ungurasu/stabilizator_tensiune_ers/Documentatie.pdf

UNIVERSITATEA POLITEHNICA din BUCURESTI
Facultatea de Electronică, Telecomunicații și Tehnologia Informației Ungurașu Ioan-Andrei 435E

București 2020

# Referat Proiect 1 - Dispozitive și circuite electronice Stabilizator de tensiune cu element de reglaj serie

Ungurașu Ioan-Andrei
Grupa 435E

## Cuprins

## Tema proiectului și datele

### Date stabilizator:

- N = 21
- Tensiunea de ieșire reglabilă în intervalul 10.5 – 21 V.
- Sarcina la ieșire de 1.05 kOhm.
- Deriva termică 1.06 < 2 mV/oC.
- Protecție la suprasarcină la 100 oC și la curent maxim 0.4 A.
- Tensiunea de intrare în intervalul 37.8 – 42 V.
- Domeniul temperaturilor 0o – 70oC.
- Amplificarea în tensiune minimă (în buclă deschisă) a amplificatorului de eroare:
- minim 200.
- Semnalizarea prezenței tensiunilor de intrare/ieșire cu diodă de tip LED.

### Cerințe privind realizarea:

Circuitul va fi realizat sub forma unui modul electronic a carui structura de interconectare (PCB) va respecta urmatoarele cerinte de proiectare:
- Dimensiunile PCB: 40mm x 40mm;
- Material FR4, dublu strat/ grosimea foliei de cupru 18 μm, grosimea plăcii 1,5 mm;
- Originea (punctul de coordonate (0,0)) va fi plasat în colţul din stânga-jos al plăcii de cablaj imprimat, astfel toate elementele proiectului vor avea coordonate pozitive;
- Dimensiunea traseelor şi spaţierea lor în concordanţă cu specificaţiile menţionate.
- Toate componentele se vor plasa pe faţă superioară a plăcii, TOP;
- Componente pasive SMD chip 0805;
- Se pot folosi numai tranzistoare bipolare şi TEC-MOS în capsule SMD (SOT 23, DPAK). Tranzistoarele TEC-J pot fi utilizate numai dacă se justifică necesitatea
acestora.
- Puncte de test: pătrate, maxim 5 – justificate de planul de testare;
- Originea (punctul de coordonate (0,0)) va fi plasat în colţul din stânga-jos al plăcii de cablaj imprimat, astfel toate elementele proiectului vor avea coordonate pozitive;
- Faţă de marginea plăcii, se va păstra o gardare („clearance”) de 1,2 mm; aici nu vor fi plasate componente, trasee, texte, etc.;
- Placa va fi prevăzută cu 2 markeri fiduciali globali pe layerul TOP, la distanța de 200 mil față de marginea plăcii, plasați convenabil; acești markeri vor exista și pe layerul
- Solder Paste Top (suprapuși peste cei de pe TOP); vor fi utilizați în momentul alinierii sablonului cu placa. Marcajul fiducial va fi un cerc de diametru minim 1mm pe layerul respectiv, aflat într-un spațiu circular de diametru minim dublu față de cercul interior, în care nu se va afla nimic pe nici un layer;
- Se va acorda o atenţie sporită layer-ului Mască de inscripţionare (Silk Screen); acesta nu trebuie să se regăsească pe pad-urile componentelor;
- Se va genera un nou layer neelectric, MECANIC. Acesta va conţine: conturul plăcii, desenul de găurire („drill drawing”) şi tabelul de găurire („drill chart/table”, „drill legend”), o secţiune transversală prin circuitul imprimat proiectat („layer stack-up”) şi informaţiile mecanice necesare pentru fabricaţia PCB;
- Cotele de gabarit/dimensiunile plăcii nu trebuie să se regăsească pe layer-ul electric TOP; acestea, dacă există, se vor plasa pe un layer neelectric mecanic;
- Placa va fi prevăzută cu elementele de identificare ale proiectantului (nume, prenume, grupă, PDCE I 2020-2021).

### Cerințe privind traseele de interconectare

- Curent de sute de 1A – 30 mil ;
- Curent de sute de mA - 22 mil;
- Semnal – 16 mil ;
- Spaţierea, în toate cazurile, va fi de 12 mil.
- Găurile de trecere pentru semnale (vias-uri) vor avea diametrul de 0,4 mm.

### Cerințe privind fisierele Gerber standard 274X

- Conturul plăcii (board outline);
- Layer electric TOP;
- Layer electric BOTTOM;
- Layer neelectric Mască de inscripţionare (Silk Screen Top);
- Layer neelectric Mască de protecţie (Solder Mask Top);
- Layer neelectric Şablon (Solder Paste Top);
- Lista de aperturi şi fişierul de găurire.

## Schema bloc

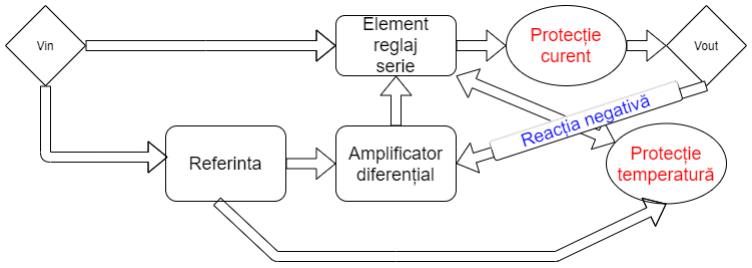
[picture p1: figure]

## Schema electrică

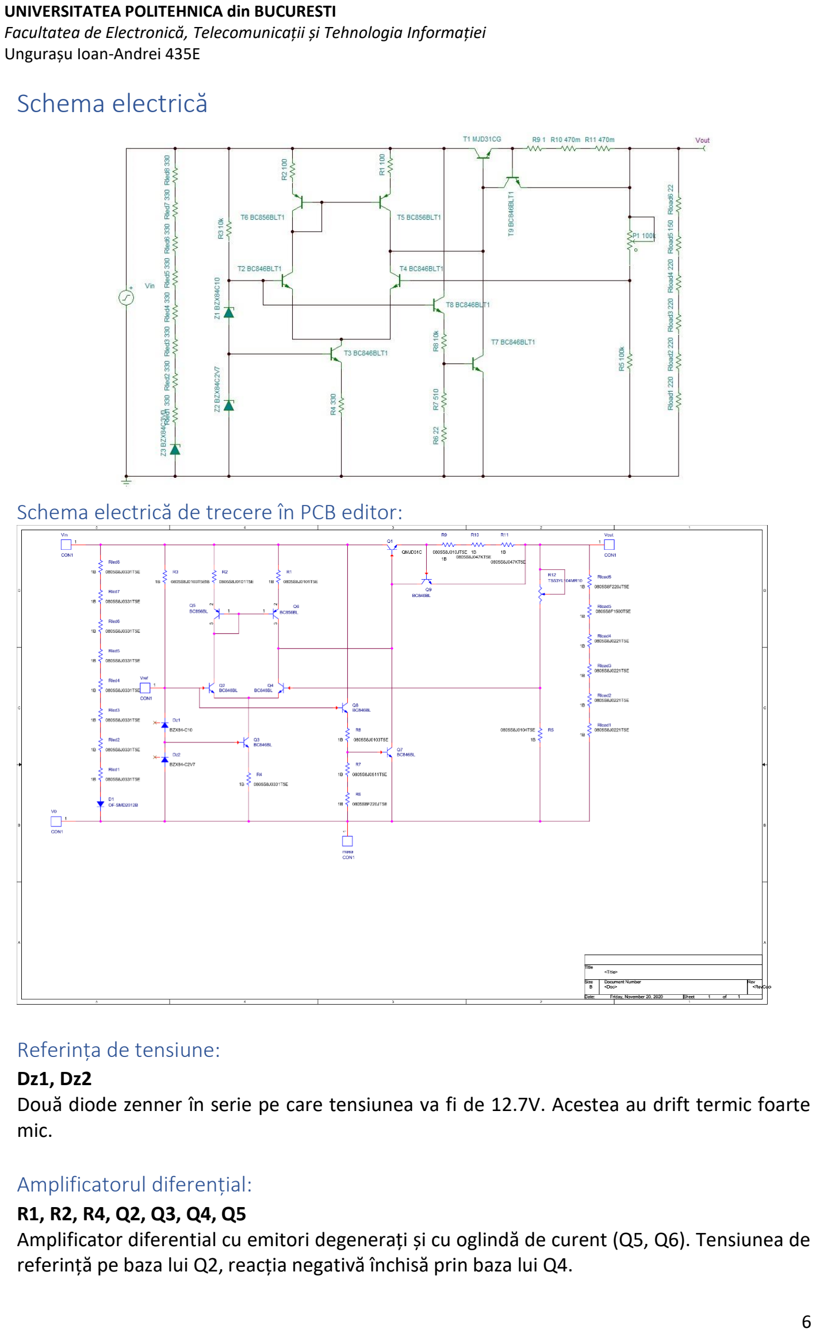
[picture p2: page 6]

### Schema electrică de trecere în PCB editor:

### Referința de tensiune:

Dz1, Dz2
Două diode zenner în serie pe care tensiunea va fi de 12.7V. Acestea au drift termic foarte mic.

### Amplificatorul diferențial:

R1, R2, R4, Q2, Q3, Q4, Q5
Amplificator diferential cu emitori degenerați și cu oglindă de curent (Q5, Q6). Tensiunea de referință pe baza lui Q2, reacția negativă închisă prin baza lui Q4.

Amplificarea în buclă deschisă:
av = gm4 × Ro = gm4 × (Rπ1 + (1 + β) × [(R5 + RP1

)||RLOAD]).

### Element de reglaj serie:

Q1
De tip MJD31C pentru a face față curentuluide ordinul sutelor de miliamperi care poate apărea înainte de activarea protecției în curent.

### Rețeaua de reacție:

P1(R12),R5
Tensiunea eșantionată Veș | = VOUT | ×

R5
R5+R12

### Circuitul de protecție în temperatură:

Q8, Q7, R6, R7, R8
Deriva termică fiind de 2mV/degC, și observând că tranzistorul are nevoie de Vbe aproximativ 800mV în viața reală pentru a se deschide complet, am pus la baza lui un divizor de tensiune care să îl țină la 600mV.

### Circuitul de protecție în curent:

Q9, R9, R10, R11
Am ales rezistențele în așa fel încât atunci când pe la colectorul lui Q1 avem un curent de 400mA, să avem Vbe9= 800mV, ca să se deschide Q9, protecția.

### Calcule

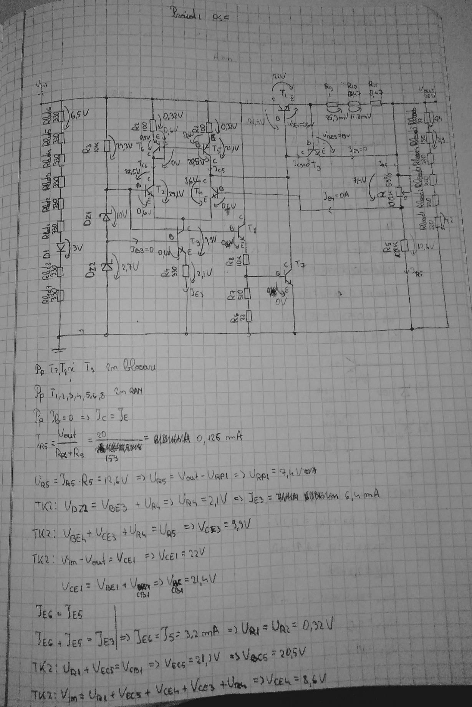
[picture p3: figure]

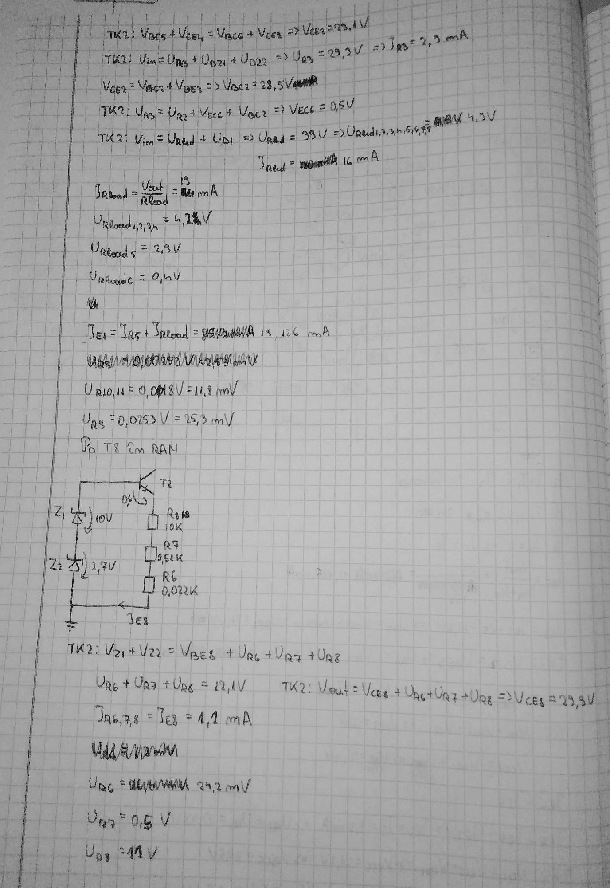
[picture p4: figure]

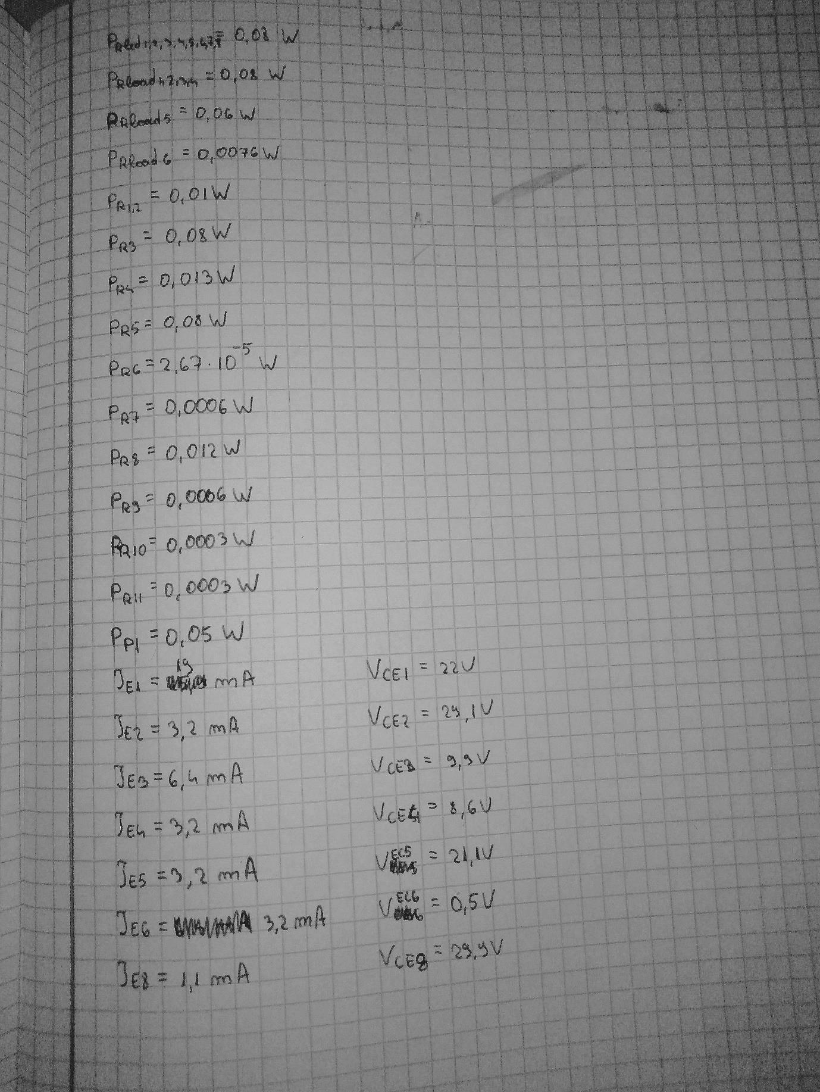
[picture p5: figure]

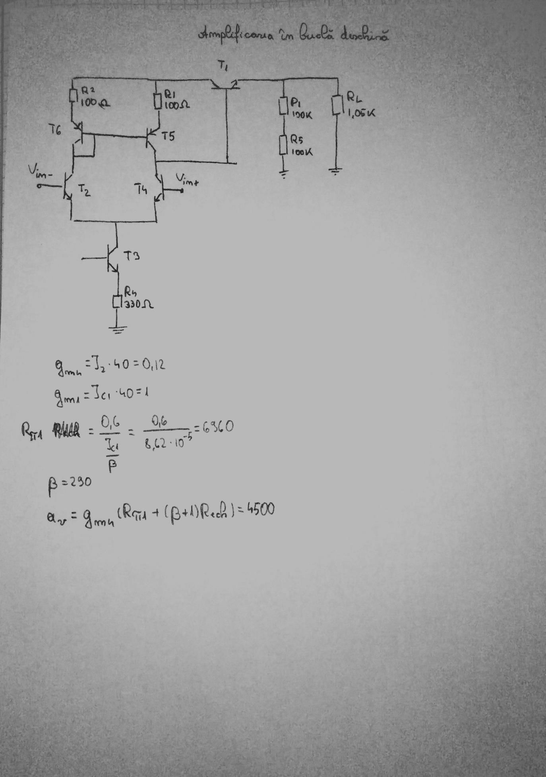
[picture p6: figure]

### Componente

Item | Quantity | Reference | Part | Valori standard | Tip constructiv
1 | 1 | Dz1 | BZX84-C10
2 | 1 | Dz2 | BZX84-C2V7
3 | 1 | D1 | OF-SMD2012B
4 | 1 | Q1 | QMJD31C
5 | 6 | Q2, Q3, Q4, Q7, Q8, Q9 | BC846BL
6 | 2 | Q5, Q6 | BC856BL
7 | 9 | Rled1, Rled2, Rled3, Rled4, R4, Rled5, Rled6, Rled7, Rled8 | 0805S8J0331T5E | 330 [Ohm] | Thick Film
8 | 4 | Rload1, Rload2, Rload3, Rload4 | 0805S8J0221T5E | 220 [Ohm] | Thick Film
9 | 1 | Rload5 | 0805S8F1500T5E | 150 [Ohm] | Thick Film
10 | 2 | Rload6, R6 | 0805S8F220JT5E | 22 [Ohm] | Thick Film
11 | 2 | R1, R2 | 0805S8J0101T5E | 100 [Ohm] | Thick Film
12 | 2 | R3, R8 | 0805S8J0103T5E | 10 [kOhm] | Thick Film
13 | 1 | R5 | 0805S8J0104T5E | 100 [kOhm] | Thick Film
14 | 1 | R7 | 0805S8J0511T5E | 510 [Ohm] | Thick Film
15 | 1 | R9 | 0805S8J010JT5E | 1 [Ohm] | Thick Film
16 | 2 | R10, R11 | 0805S8J047KT5E | 0.47 [Ohm] | Thick Film
17 | 1 | R12 | TS53YL104MR10 | 100 [kOhm] | Single Turn Cermet Sealed
18 | 5 | masa, Vref, Vout, Vin, V0 | CON1

## Simulări

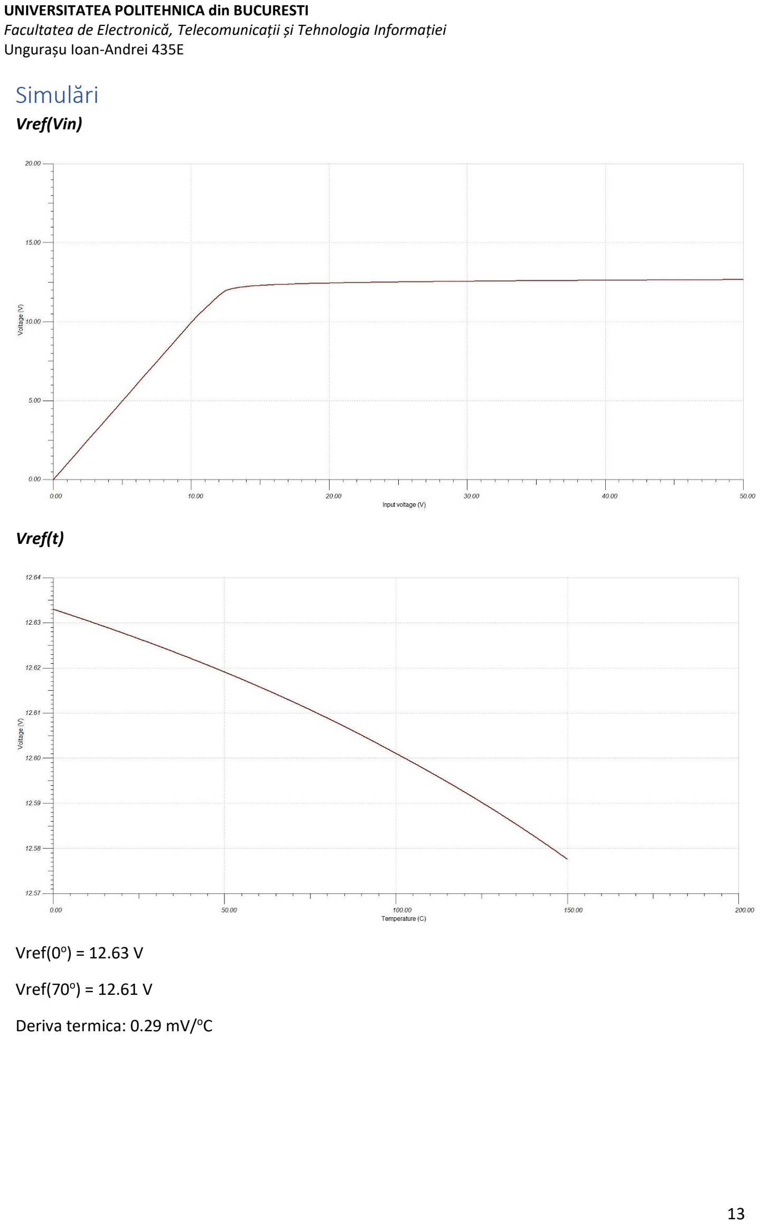
[picture p7: page 13]

Vref(Vin)

Vref(t)

Vref(0o
) = 12.63 V

Vref(70o
) = 12.61 V

Deriva termica: 0.29 mV/oC

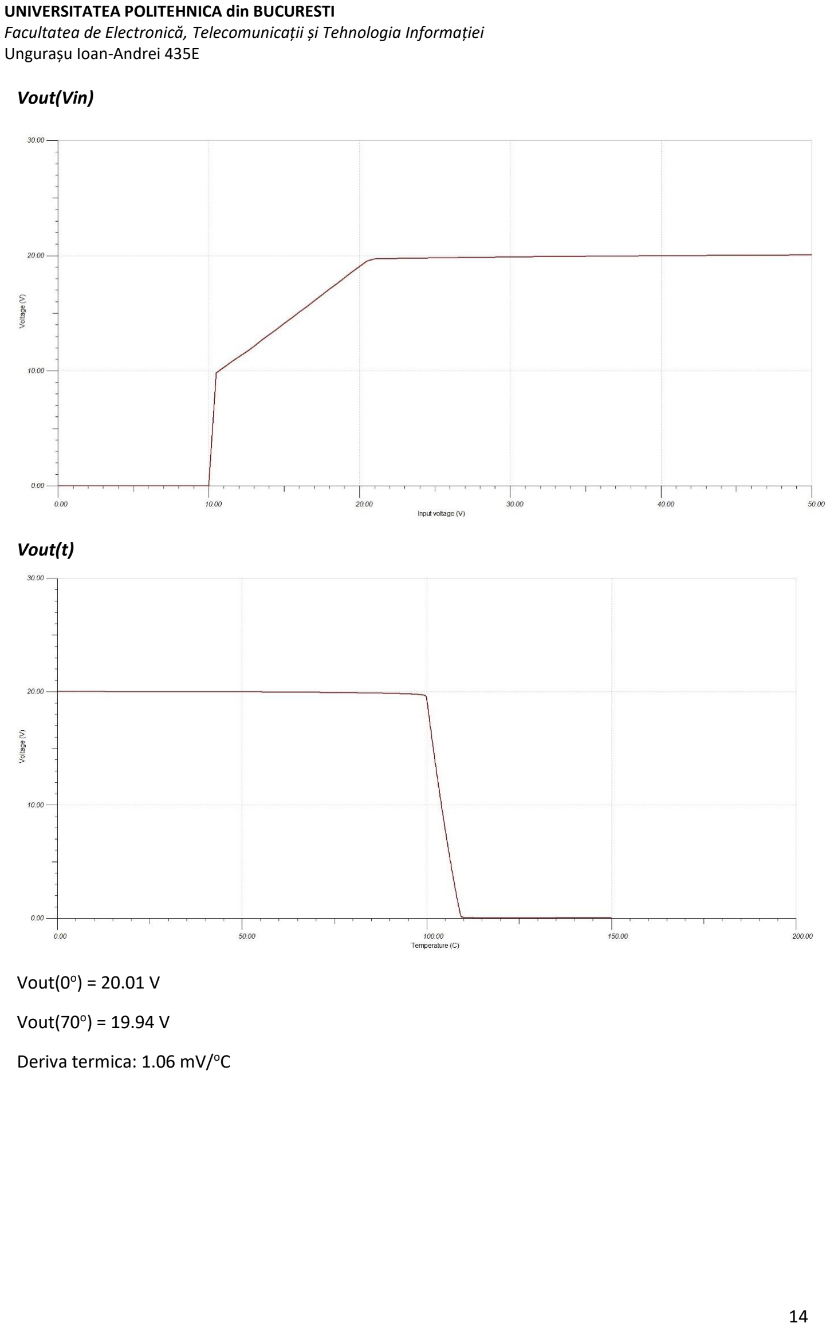
[picture p8: page 14]

Vout(Vin)

Vout(t)

Vout(0o
) = 20.01 V

Vout(70o
) = 19.94 V

Deriva termica: 1.06 mV/oC

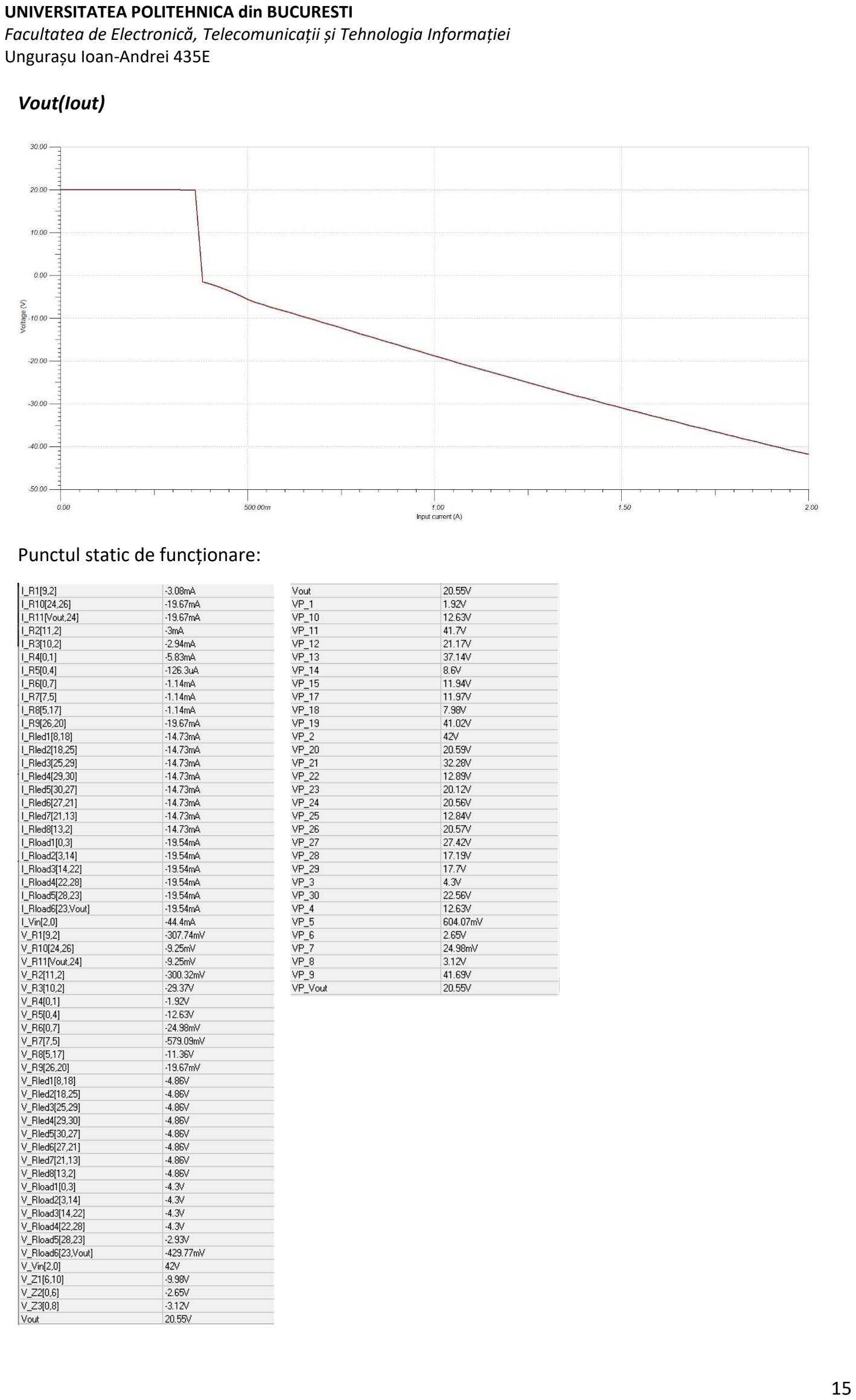
[picture p9: page 15]

Vout(Iout)

Punctul static de funcționare:

## Layout

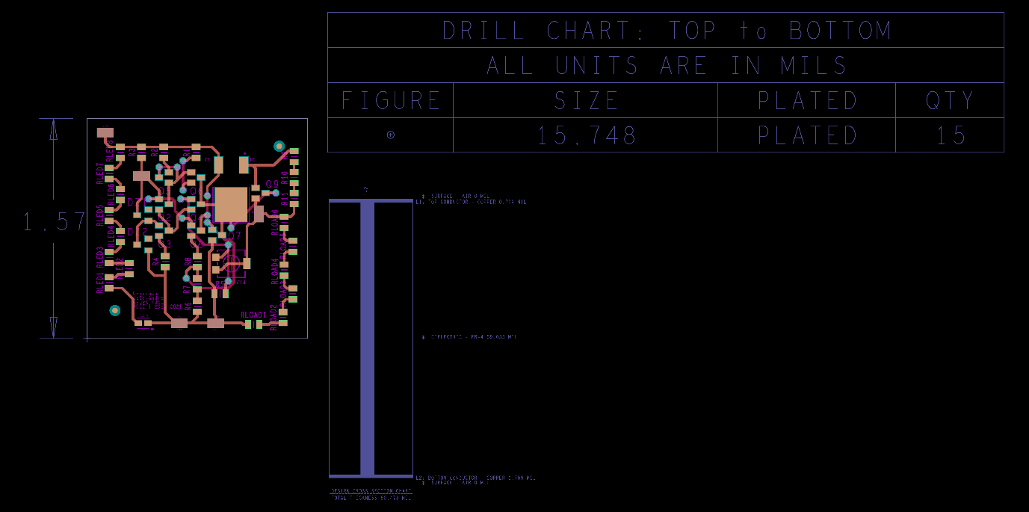
[picture p10: figure]

## TOP

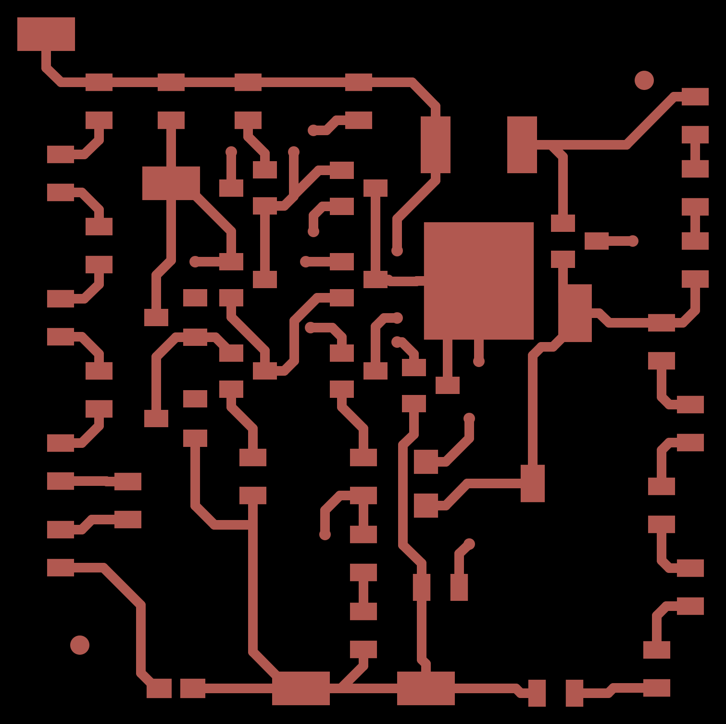
[picture p11: figure]

## BOT

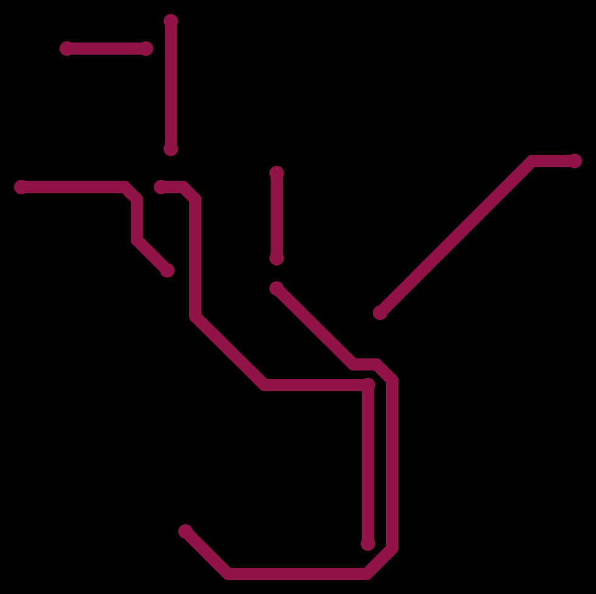
[picture p12: figure]

## Silk Screen Top

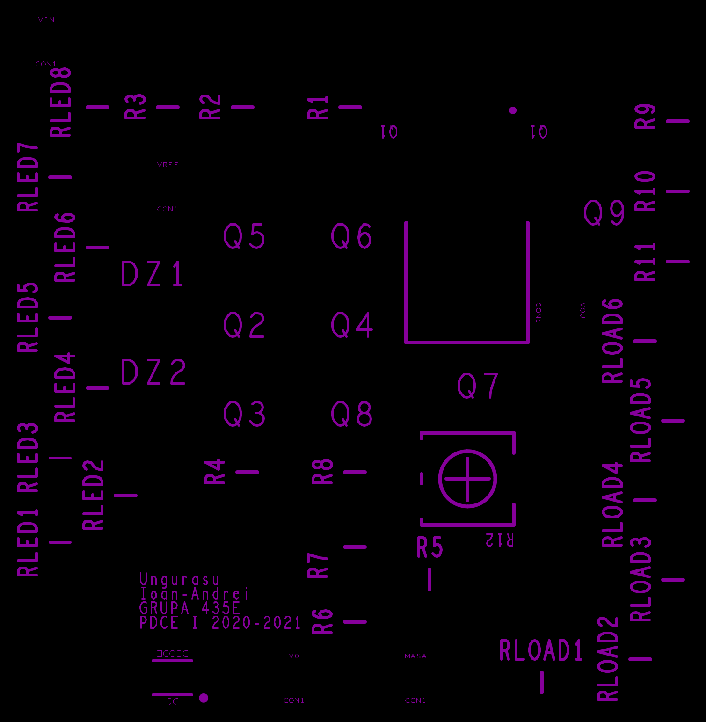
[picture p13: figure]

## Solder Mask Top

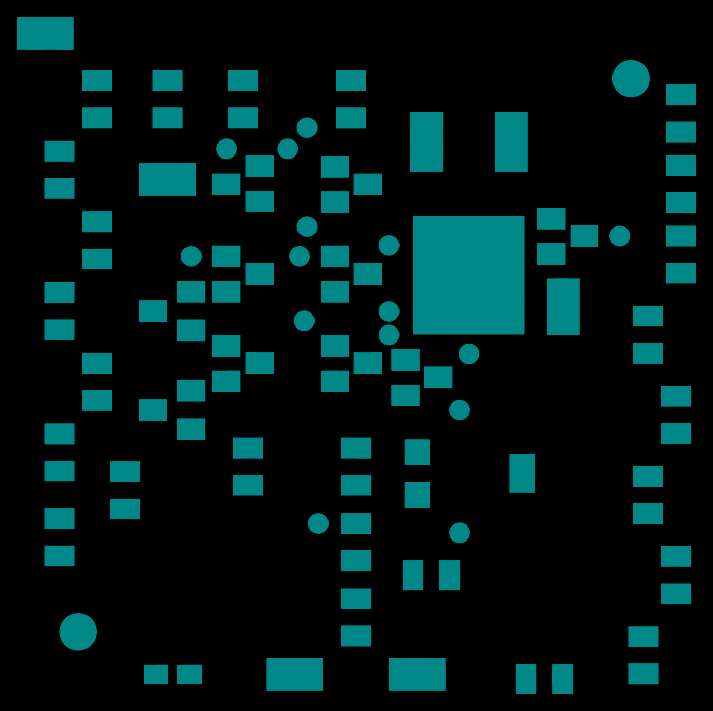
[picture p14: figure]

## Solder Paste Top

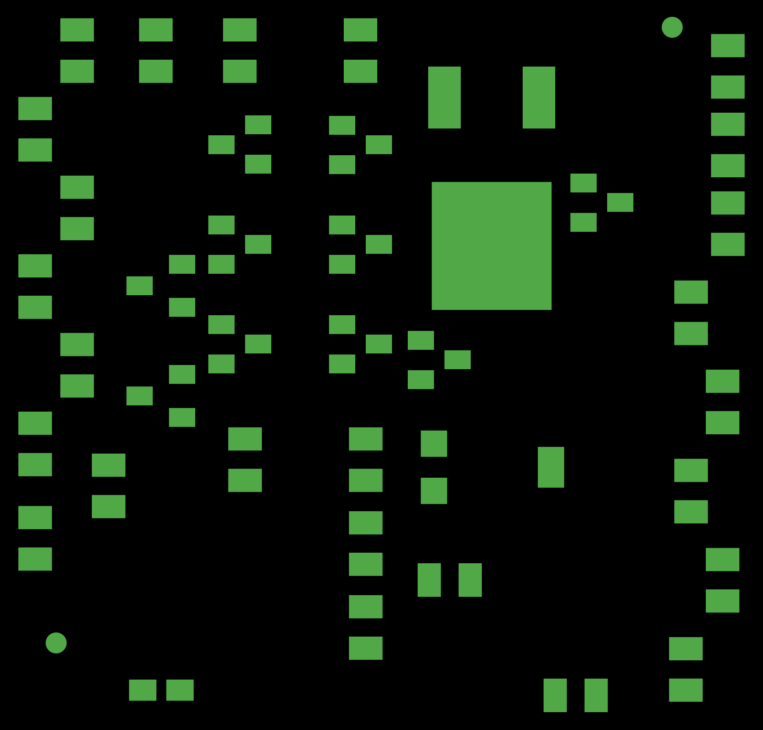
[picture p15: figure]

## Fab

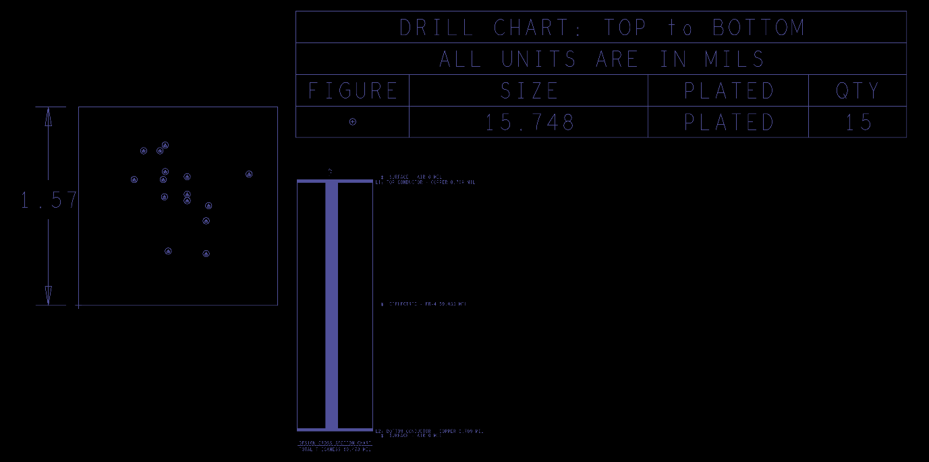
[picture p16: figure]

## Foaie de catalog

### Caracteristici:

Tensiunea de ieșire reglabilă în intervalul 10.5 – 21 V. Sarcina la ieșire de 1.05 kOhm.
Deriva termică 1.06 mV/oC.
Protecție la suprasarcină la 100 oC și la curent maxim 0.4 A.
Tensiunea de intrare în intervalul 37.8 – 42 V.
Domeniul temperaturilor 0o – 70oC.
Amplificarea în tensiune minimă (în buclă deschisă) a amplificatorului de eroare 4500. Dimensiunile PCB: 40mm x 40mm.
Material PCB: FR4, dublu strat/grosimea foliei de cupru 18 μm, grosimea plăcii 1,5 mm. Conectori: masa, Vref, Vout, Vin, V0.

### Mod de utilizare:

Bornele +/- ale sursei de curent continuu se vor regla la conectorii Vin/masa. Tensiunea de ieșire se va regla din potențiometrul P1.
Tensiunea de ieșire se va măsura cu ajutorul conectorilor Vout și masa/V0. Tensiunea de referință se va măsura cu ajutorul Vref și masa/V0.
