ungurasu/stabilizator_tensiune_ers/schema electrica PCB.png

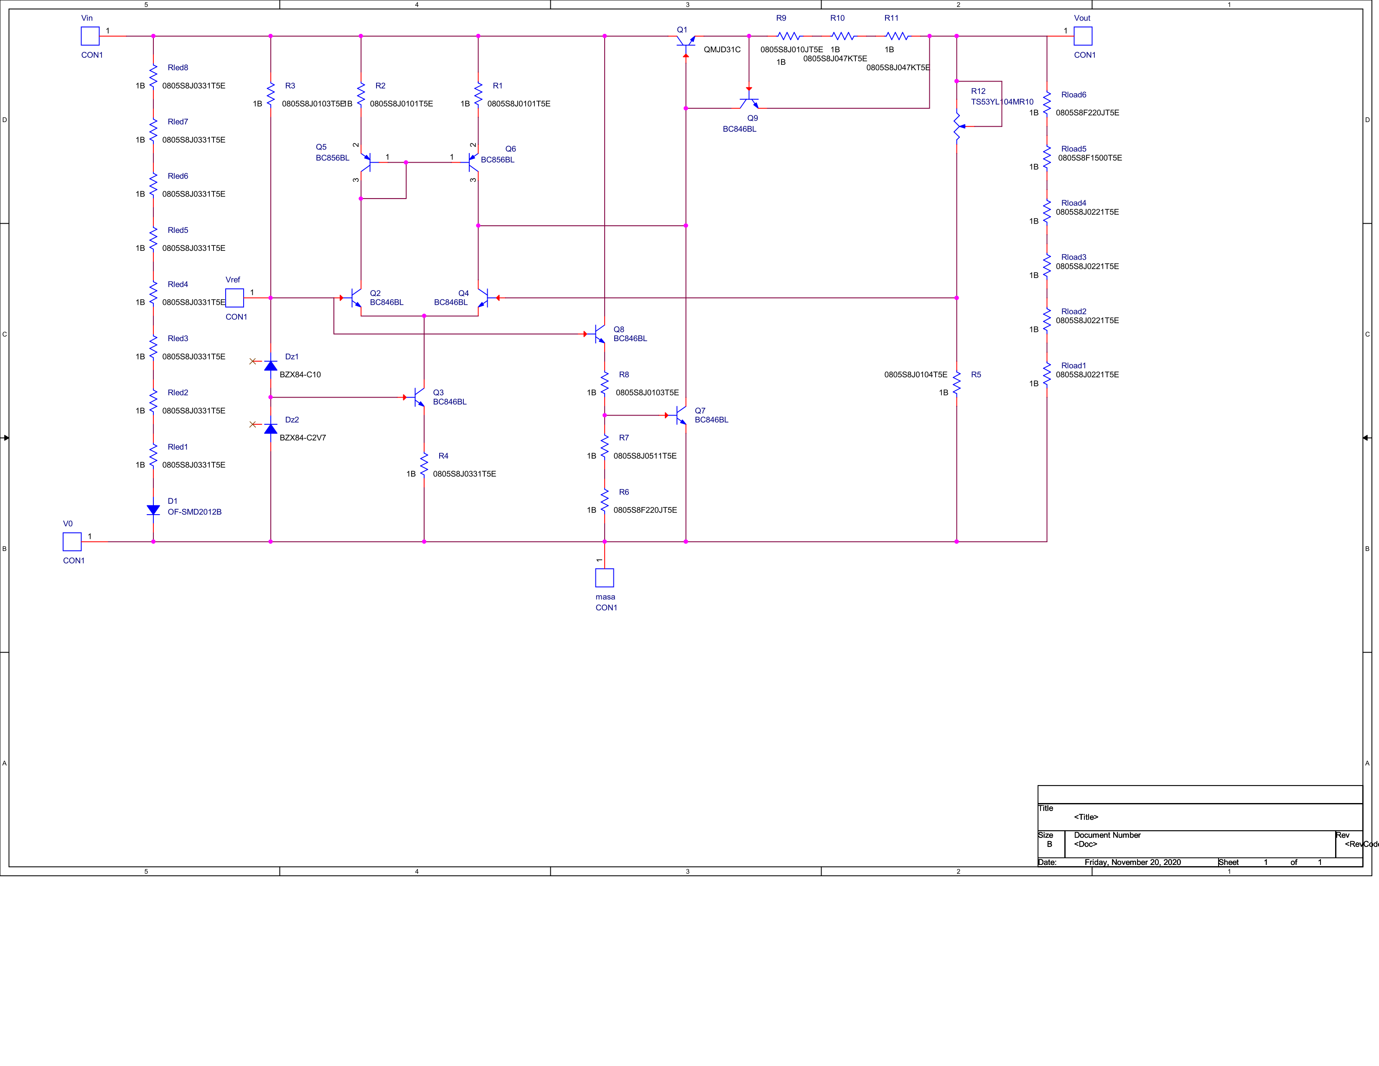
schema electrica PCB.png
