ungurasu/stabilizator_tensiune_ers/schema electrica.JPG

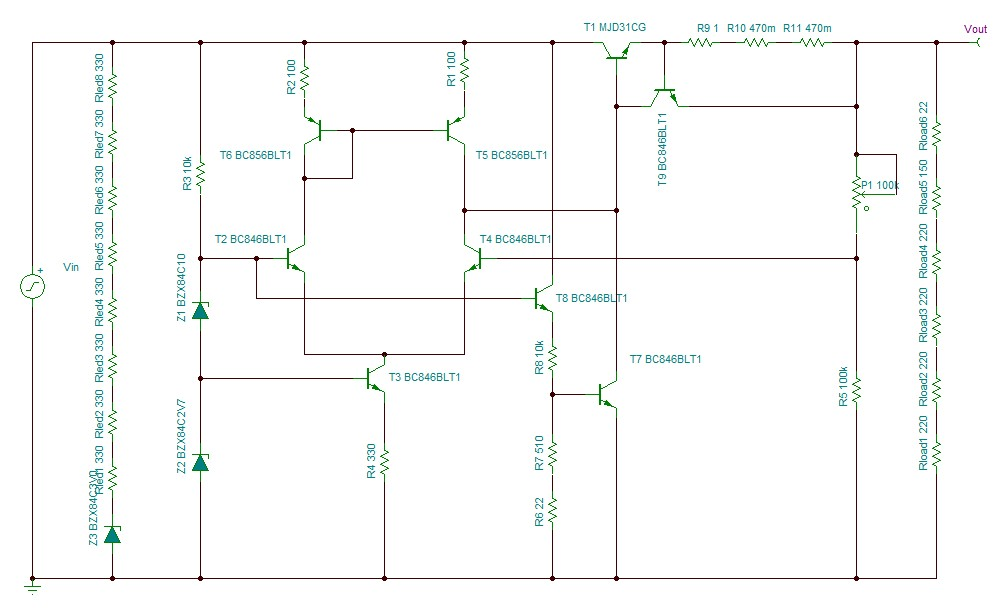
schema electrica.JPG
