ungurasu/stabilizator_tensiune_ers/Simulations/Vout(Iout).jpg

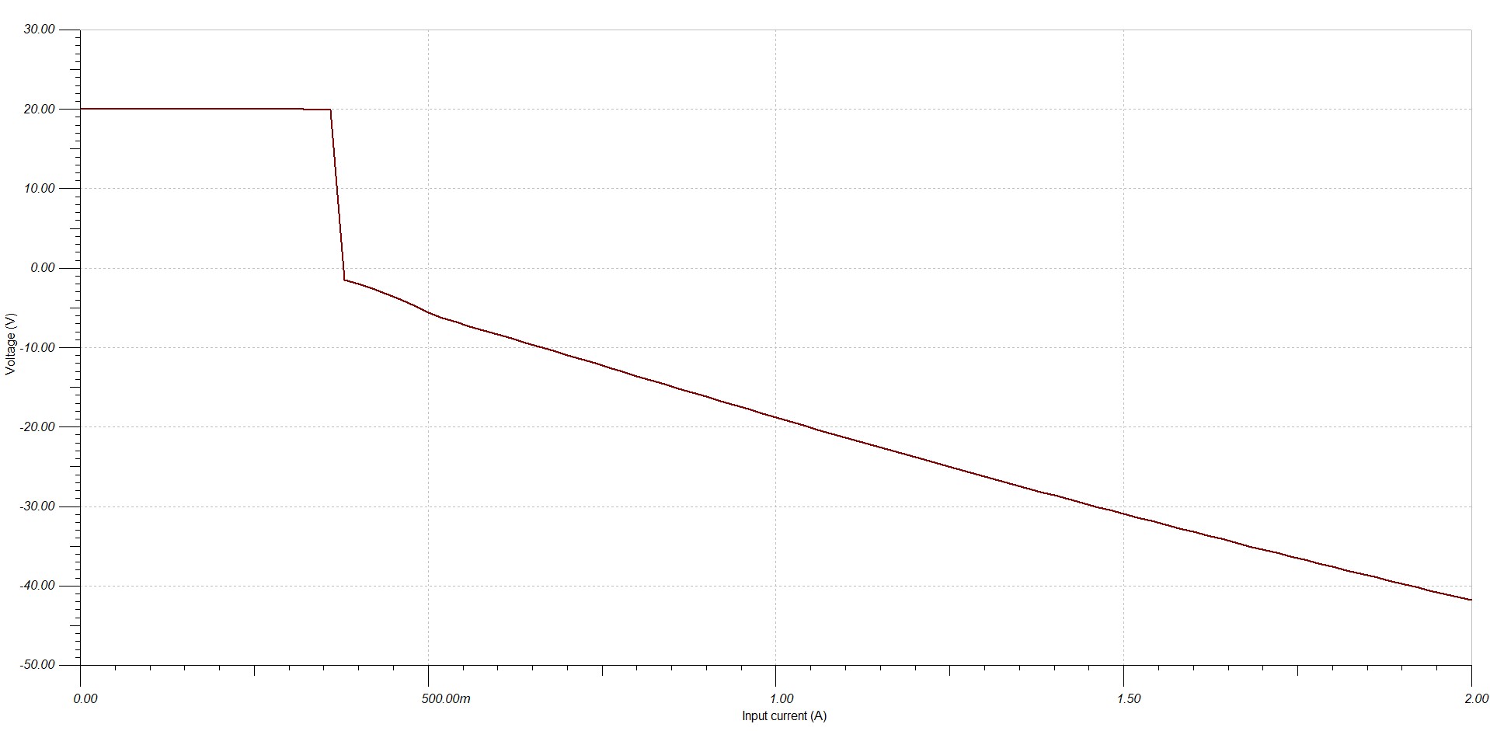
Simulations/Vout(Iout).jpg
