ungurasu/stabilizator_tensiune_ers/Simulations/Vout(t).jpg

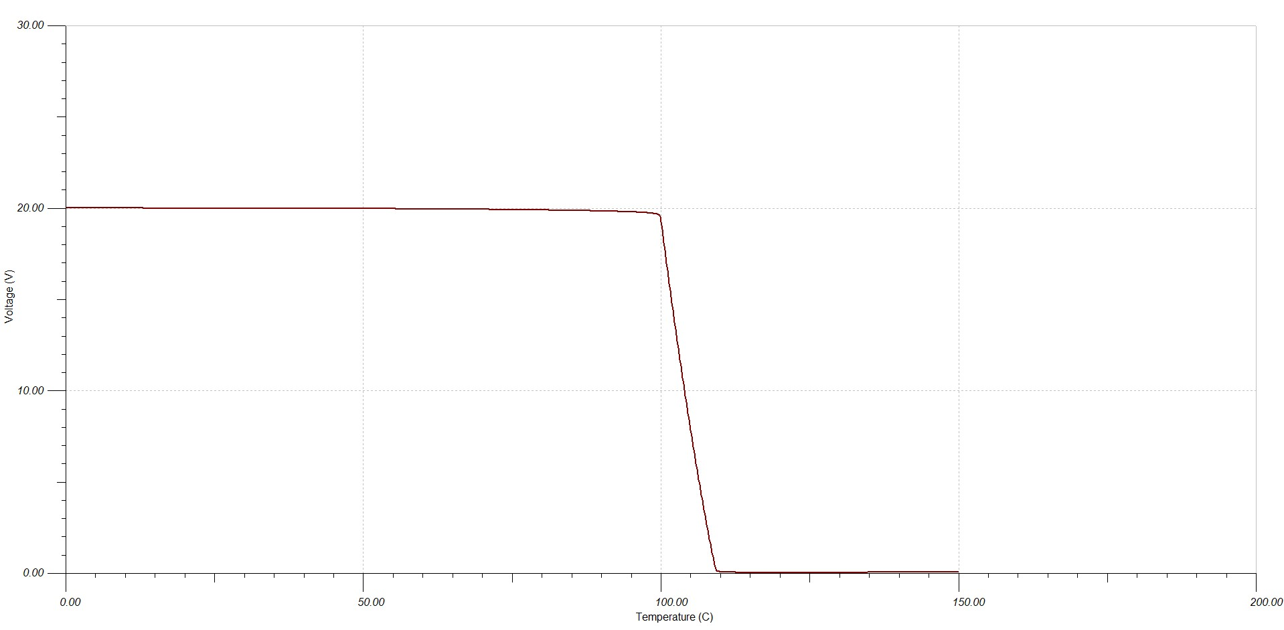
Simulations/Vout(t).jpg
