ungurasu/stabilizator_tensiune_ers/Simulations/Vout(Vin).jpg

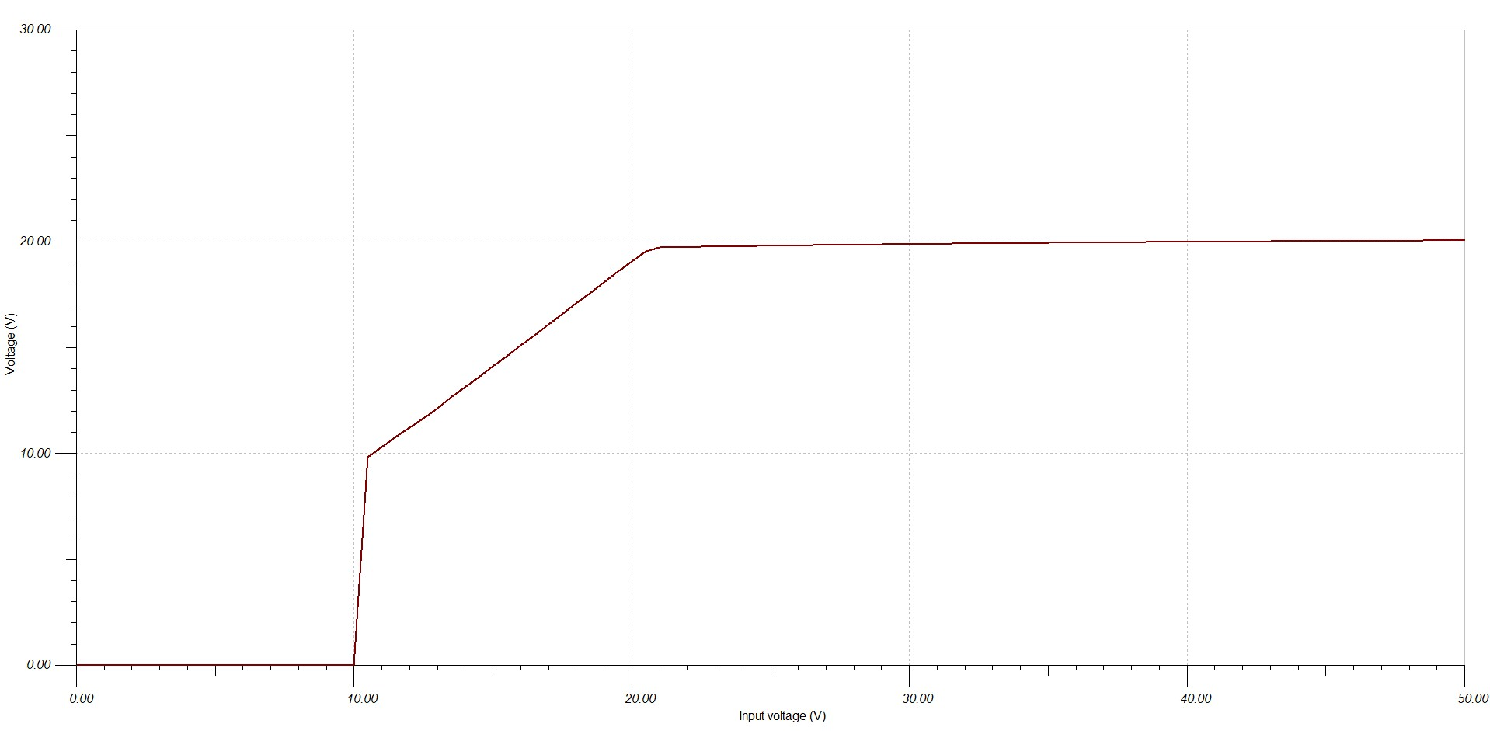
Simulations/Vout(Vin).jpg
