ungurasu/stabilizator_tensiune_ers/Simulations/Vref(t).jpg

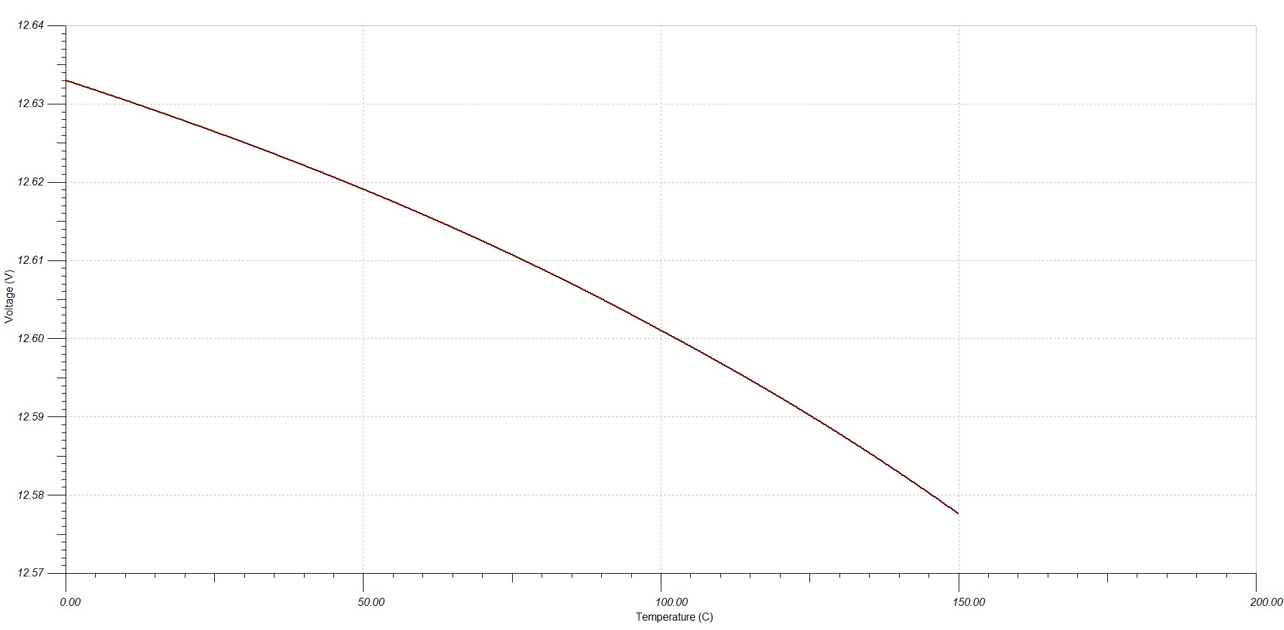
Simulations/Vref(t).jpg
