ungurasu/stabilizator_tensiune_ers/Simulations/Vref(Vin).jpg

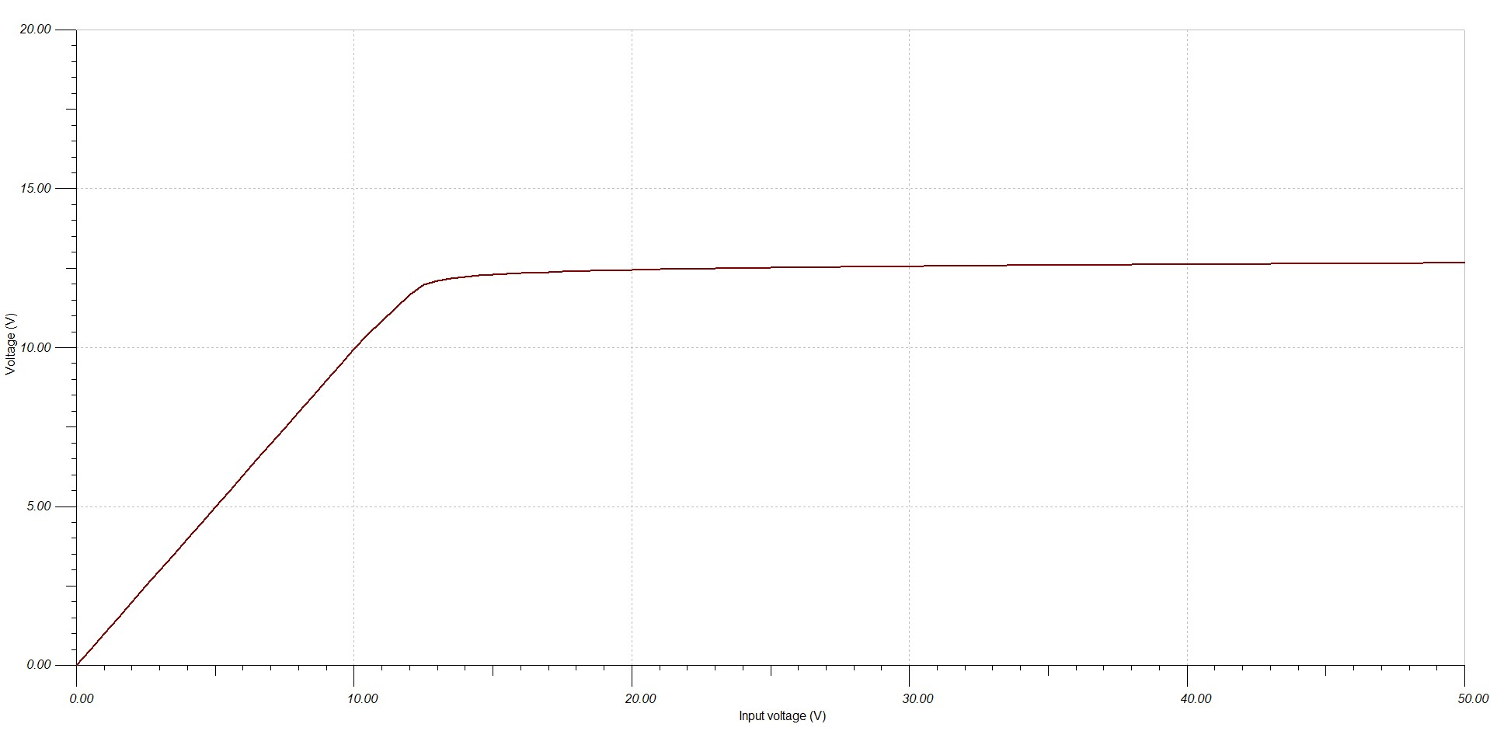
Simulations/Vref(Vin).jpg
